cloudglides/AUB/images/1-staging.png

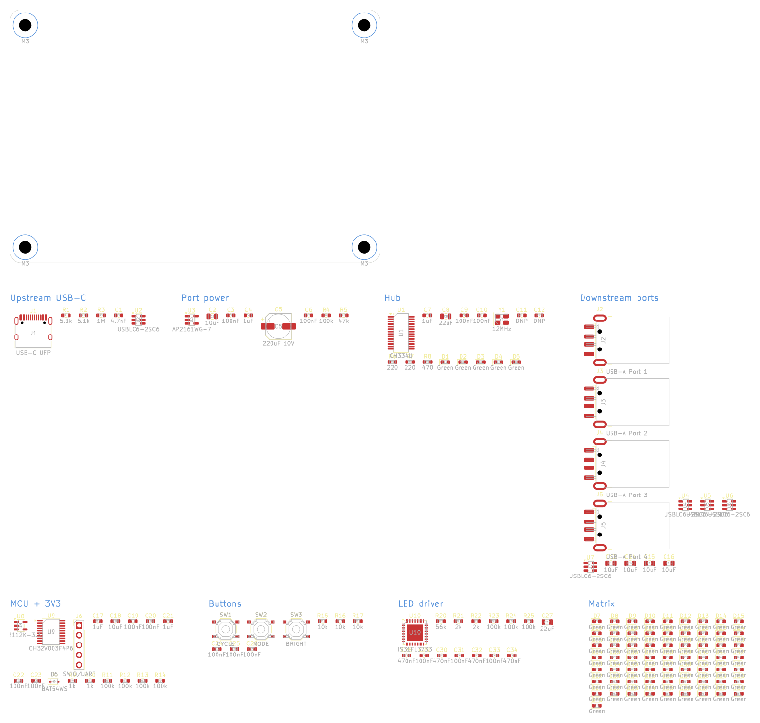
images/1-staging.png
