cloudglides/AUB/images/2-placement-3d.png

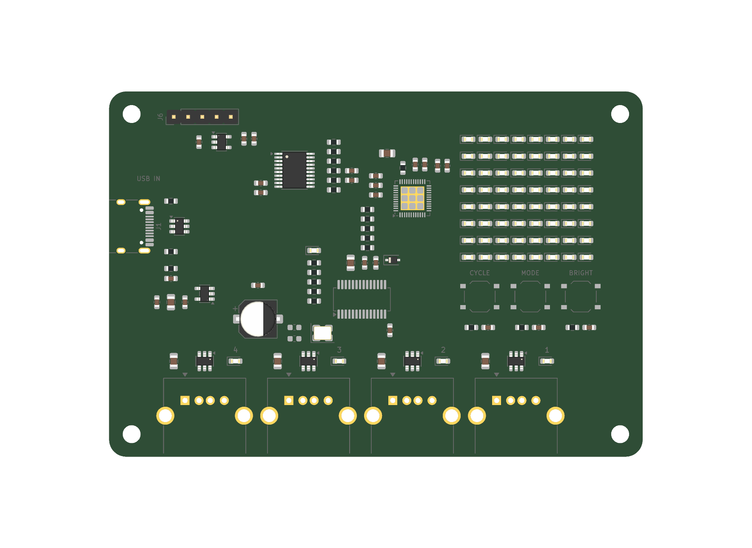
images/2-placement-3d.png
