cloudglides/AUB/images/2-placement-top.png

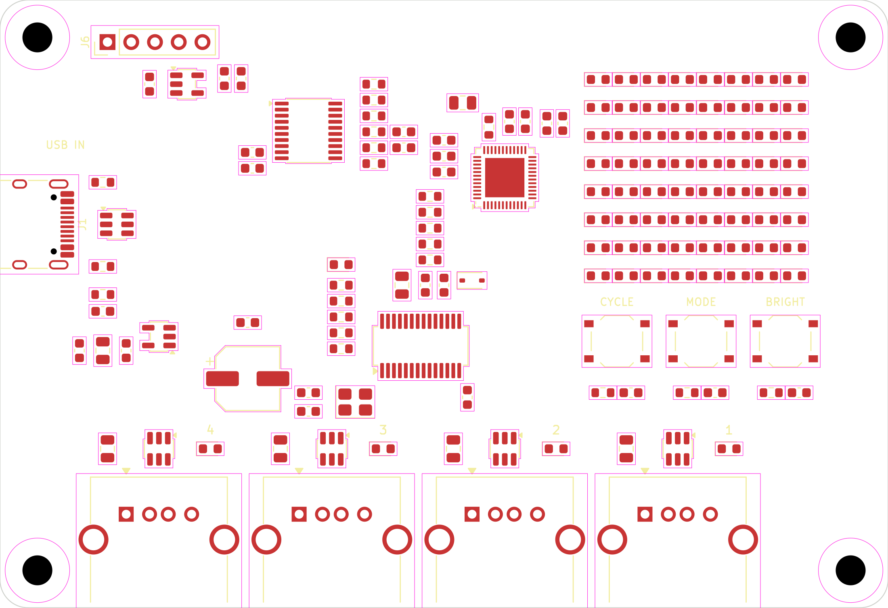
images/2-placement-top.png
