cloudglides/AUB/images/3-routing-wip-copper.png

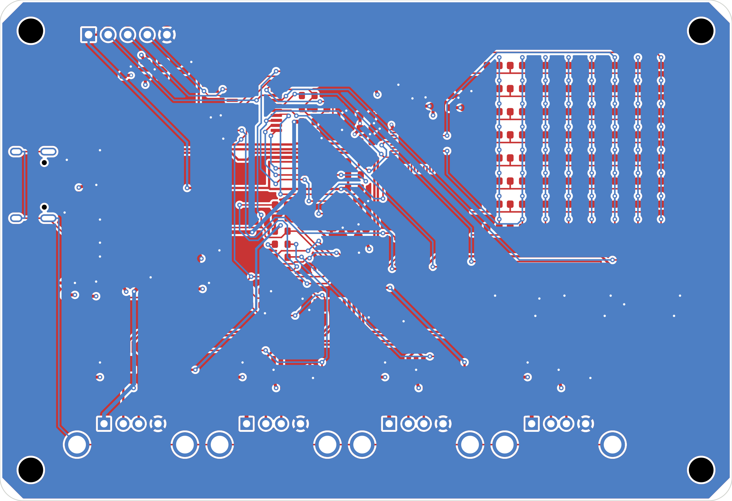
images/3-routing-wip-copper.png
