cloudglides/AUB/images/4-final-copper.png

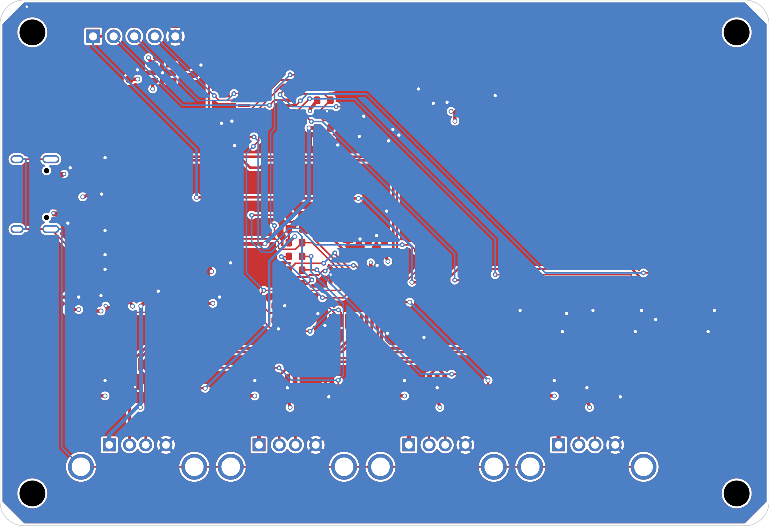
images/4-final-copper.png
