cloudglides/AUB/images/schematic.png

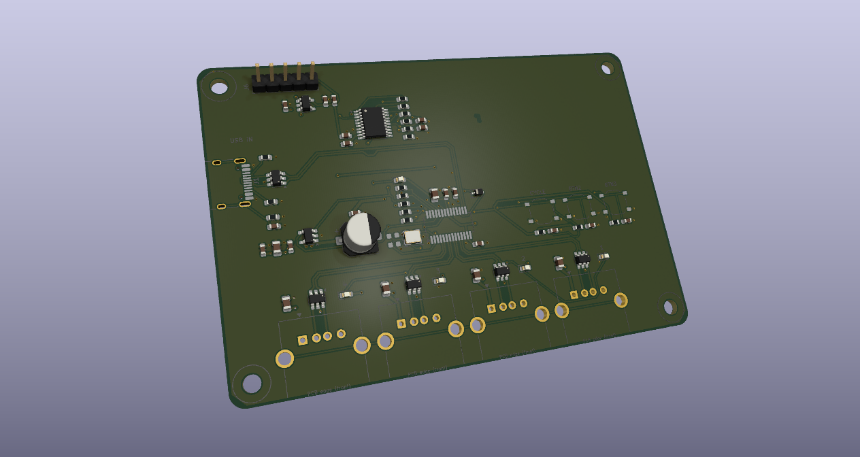
images/schematic.png
