cloudglides/AUB/BOM.csv

Comment | Designator | Footprint | LCSC Part # | Quantity
4.7nF | C1 | C_0603_1608Metric | C53987 | 1
10uF | C2,C13,C14,C15,C16 | C_0805_2012Metric | C15850 | 5
100nF | C3,C6,C9,C10,C19,C20,C22,C23,C24,C25,C26 | C_0603_1608Metric | C1591 | 11
1uF | C4,C7,C17,C21 | C_0603_1608Metric | C15849 | 4
220uF 10V | C5 | CP_Elec_6.3x7.7 | C5155344 | 1
22uF | C8 | C_0805_2012Metric | C602037 | 1
10uF | C18 | C_0603_1608Metric | C19702 | 1
Green | D1,D2,D3,D4,D5 | LED_0603_1608Metric | C7496818 | 5
BAT54WS | D6 | D_SOD-323 | C3040452 | 1
USB-C UFP | J1 | USB_C_Receptacle_HRO_TYPE-C-31-M-12 | C165948 | 1
USB-A Receptacle (902-131A1011D10100) | J2,J3,J4,J5 | USB_A_Receptacle_902-131A1011D10100 | C2345 | 4
SWIO/UART | J6 | PinHeader_1x05_P2.54mm_Vertical | C5156614 | 1
5.1k | R1,R2 | R_0603_1608Metric | C23186 | 2
1M | R3 | R_0603_1608Metric | C22935 | 1
100k | R4,R11,R12,R13,R14 | R_0603_1608Metric | C25803 | 5
47k | R5 | R_0603_1608Metric | C25819 | 1
220 | R6,R7 | R_0603_1608Metric | C22962 | 2
470 | R8 | R_0603_1608Metric | C23179 | 1
1k | R9,R10 | R_0603_1608Metric | C21190 | 2
10k | R15,R16,R17 | R_0603_1608Metric | C25804 | 3
Tactile Switch 5.1x5.1 (TS-1187A-B-A-B) | SW1,SW2,SW3 | SW_Push_1P1T_XKB_TS-1187A | C318884 | 3
CH334U | U1 | QSOP-28_3.9x9.9mm_P0.635mm | C5187524 | 1
USBLC6-2SC6 | U2,U4,U5,U6,U7 | SOT-23-6 | C7519 | 5
AP2161WG-7 | U3 | SOT-23-5 | C176957 | 1
AP2112K-3.3 | U8 | SOT-23-5 | C51118 | 1
CH32V003F4P6 | U9 | TSSOP-20_4.4x6.5mm_P0.65mm | C5187096 | 1
12MHz | Y1 | Crystal_SMD_3225-4Pin_3.2x2.5mm | C9002 | 1
