cloudglides/AUB/docs/AUB-schematic.pdf

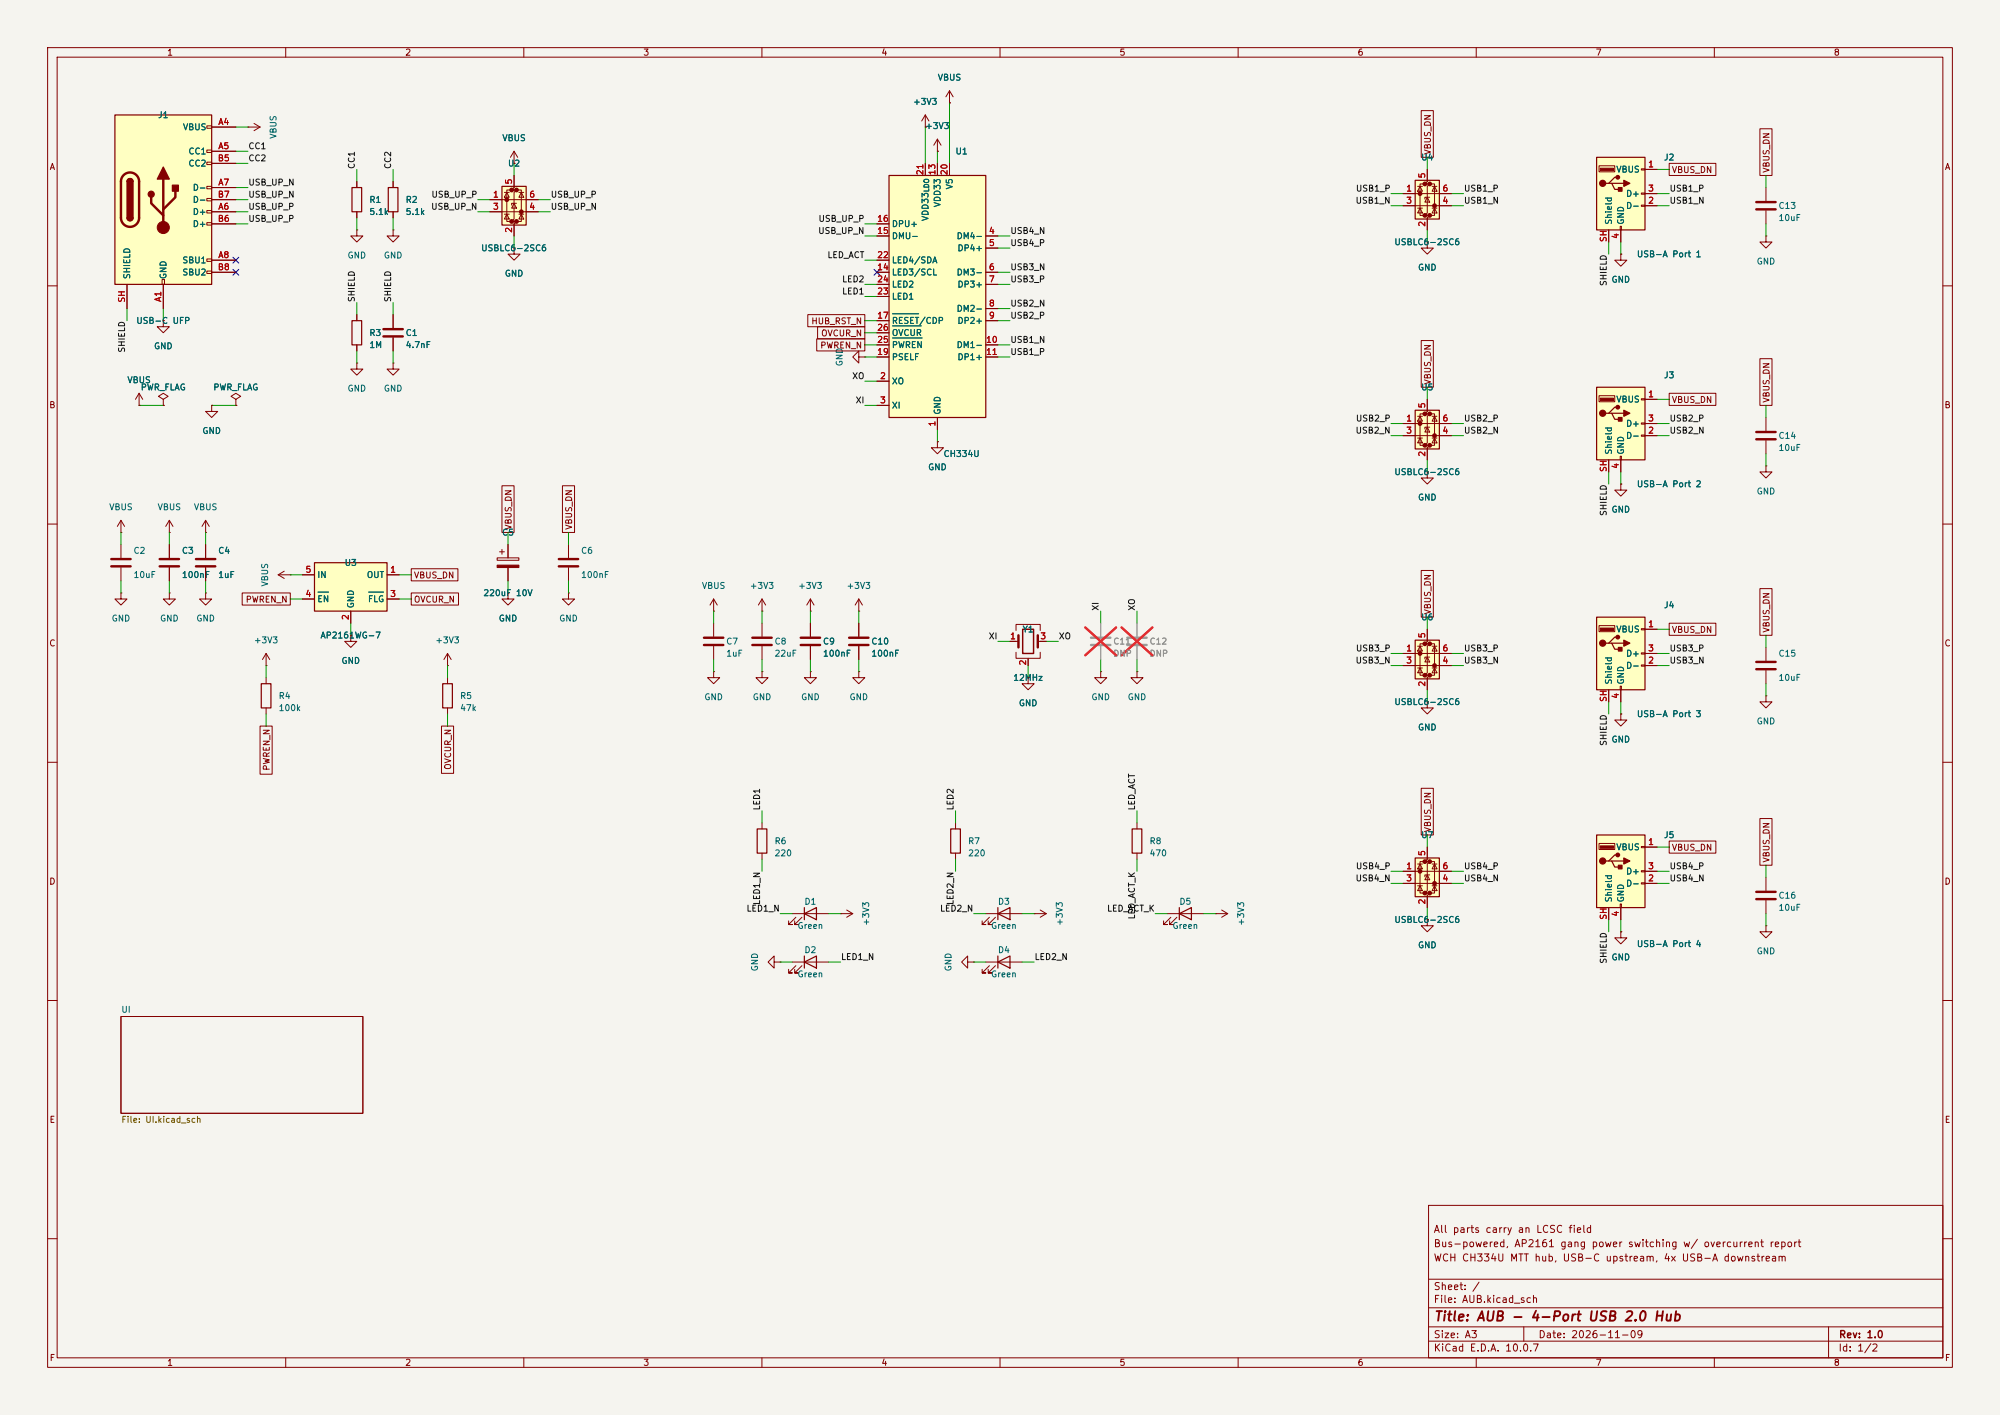
[picture p8: page 1]

J2 USB-A Port 1 GND GND

All parts carry an LCSC field
Bus-powered, AP2161 gang power switching w/ overcurrent report
WCH CH334U MTT hub, USB-C upstream, 4x USB-A downstream

Sheet: /
File: AUB.kicad_sch
Title: AUB - 4-Port USB 2.0 Hub

Size: A3 | Rev: 1.0 | F Date: 2026-11-09
KiCad E.D.A. 10.0.7 | Id: 1/2

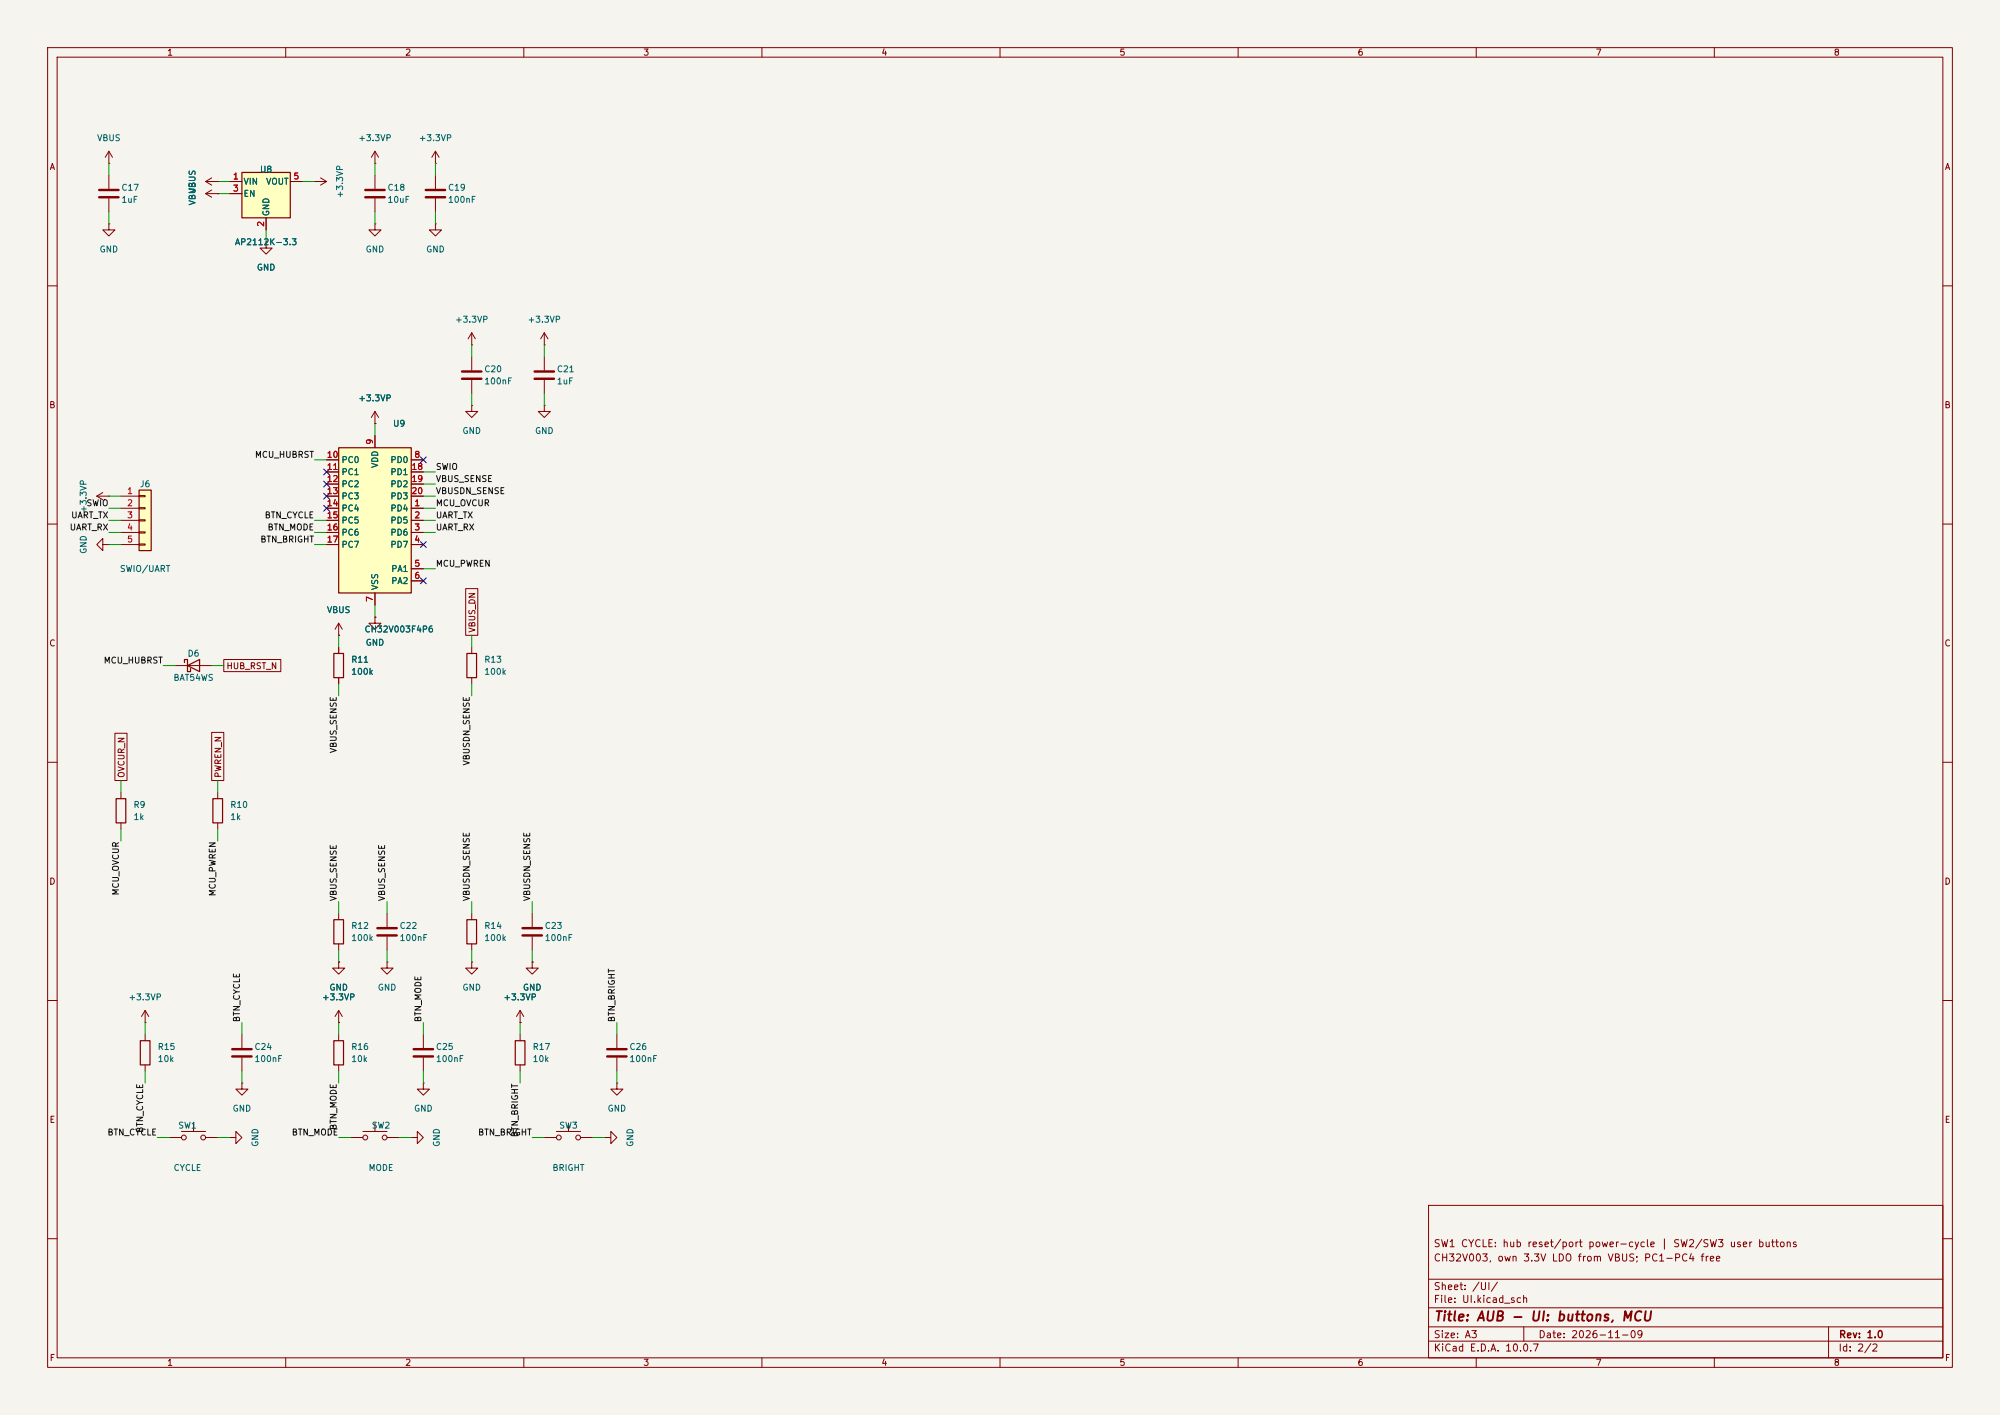
[picture p9: page 2]

SW1 CYCLE: hub reset/port power-cycle | SW2/SW3 user buttons GND

CH32V003, own 3.3V LDO from VBUS; PC1-PC4 free

Sheet: /UI/
File: UI.kicad_sch
Title: AUB - UI: buttons, MCU

Size: A3 | Rev: 1.0
KiCad E.D.A. 10.0.7 | Id: 2/2
