cloudglides/AUB/pcb/AUB.kicad_pcb

## KiCad design pcb/AUB.kicad_pcb (2026-11-09)

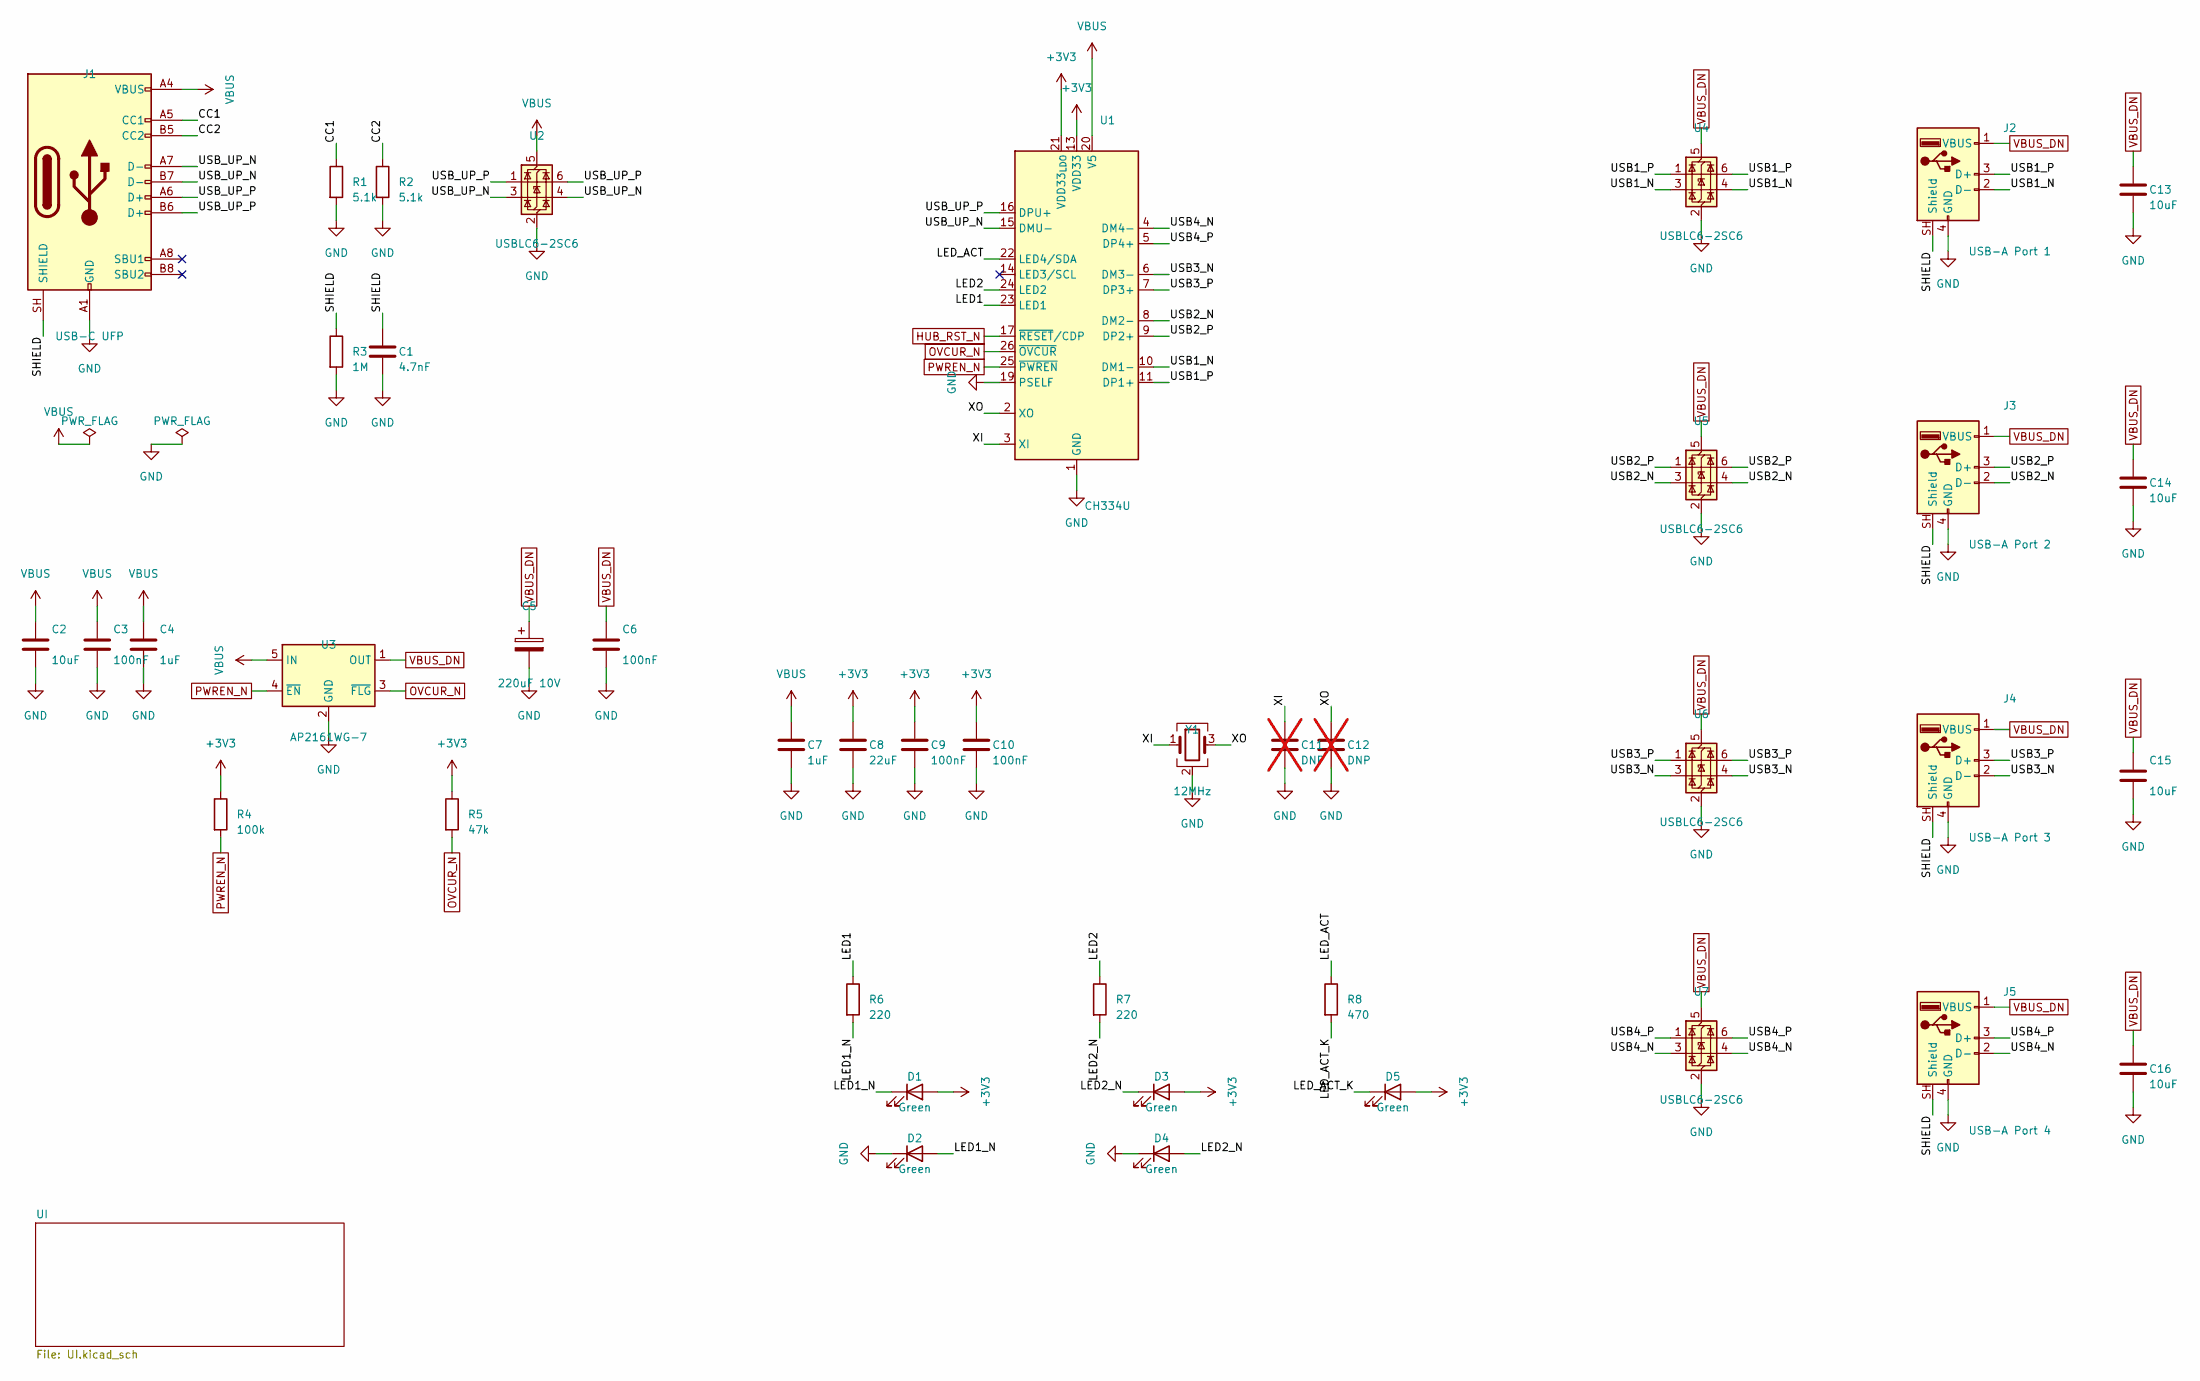
[picture p10: schematic AUB.kicad_sch, AUB - 4-Port USB 2.0 Hub]

Parts:
C1: 4.7nF; C_0603_1608Metric; LCSC C53987
C2, C13, C14, C15, C16: 10uF; C_0805_2012Metric; LCSC C15850
C3, C6, C9, C10: 100nF; C_0603_1608Metric; LCSC C1591
C4, C7: 1uF; C_0603_1608Metric; LCSC C15849
C5: 220uF 10V; CP_Elec_6.3x7.7; MPN FZ220UF10V90RV0151; LCSC C5155344
C8: 22uF; C_0805_2012Metric; LCSC C602037
C11, C12: DNP; C_0603_1608Metric; not fitted
D1, D2, D3, D4, D5: Green; LED_0603_1608Metric; LCSC C7496818
J1: USB-C UFP; USB_C_Receptacle_HRO_TYPE-C-31-M-12; MPN TYPE-C-31-M-12; LCSC C165948
J2: USB-A Port 1; USB_A_Receptacle_902-131A1011D10100; MPN 902-131A1011D10100; LCSC C2345
J3: USB-A Port 2; USB_A_Receptacle_902-131A1011D10100; MPN 902-131A1011D10100; LCSC C2345
J4: USB-A Port 3; USB_A_Receptacle_902-131A1011D10100; MPN 902-131A1011D10100; LCSC C2345
J5: USB-A Port 4; USB_A_Receptacle_902-131A1011D10100; MPN 902-131A1011D10100; LCSC C2345
R1, R2: 5.1k; R_0603_1608Metric; LCSC C23186
R3: 1M; R_0603_1608Metric; LCSC C22935
R4: 100k; R_0603_1608Metric; LCSC C25803
R5: 47k; R_0603_1608Metric; LCSC C25819
R6, R7: 220; R_0603_1608Metric; LCSC C22962
R8: 470; R_0603_1608Metric; LCSC C23179
U1: CH334U; QSOP-28_3.9x9.9mm_P0.635mm; MPN CH334U; LCSC C5187524
U2, U4, U5, U6, U7: USBLC6-2SC6; SOT-23-6; LCSC C7519
U3: AP2161WG-7; SOT-23-5; MPN AP2161WG-7; LCSC C176957
Y1: 12MHz; Crystal_SMD_3225-4Pin_3.2x2.5mm; MPN X322512MSB4SI; LCSC C9002

Connections:
+3V3: C8.1, C9.1, C10.1, D1.2 (A), D3.2 (A), D5.2 (A), R4.1, R5.1, U1.13 (VDD33), U1.21 (VDD33_{LDO})
/CC1: J1.A5 (CC1), R1.1
/CC2: J1.B5 (CC2), R2.1
/LED1: R6.1, U1.23 (LED1)
/LED1_N: D1.1 (K), D2.2 (A), R6.2
/LED2: R7.1, U1.24 (LED2)
/LED2_N: D3.1 (K), D4.2 (A), R7.2
/LED_ACT: R8.1, U1.22 (LED4/SDA)
/LED_ACT_K: D5.1 (K), R8.2
/SHIELD: C1.1, J1.SH (SHIELD), J2.SH (Shield), J3.SH (Shield), J4.SH (Shield), J5.SH (Shield), R3.1
/USB1_N: J2.2 (D-), U1.10 (DM1-), U4.3 (I/O2), U4.4 (I/O2)
/USB1_P: J2.3 (D+), U1.11 (DP1+), U4.1 (I/O1), U4.6 (I/O1)
/USB2_N: J3.2 (D-), U1.8 (DM2-), U5.3 (I/O2), U5.4 (I/O2)
/USB2_P: J3.3 (D+), U1.9 (DP2+), U5.1 (I/O1), U5.6 (I/O1)
/USB3_N: J4.2 (D-), U1.6 (DM3-), U6.3 (I/O2), U6.4 (I/O2)
/USB3_P: J4.3 (D+), U1.7 (DP3+), U6.1 (I/O1), U6.6 (I/O1)
/USB4_N: J5.2 (D-), U1.4 (DM4-), U7.3 (I/O2), U7.4 (I/O2)
/USB4_P: J5.3 (D+), U1.5 (DP4+), U7.1 (I/O1), U7.6 (I/O1)
/USB_UP_N: J1.A7 (D-), J1.B7 (D-), U1.15 (DMU-), U2.3 (I/O2), U2.4 (I/O2)
/USB_UP_P: J1.A6 (D+), J1.B6 (D+), U1.16 (DPU+), U2.1 (I/O1), U2.6 (I/O1)
/XI: C11.1, U1.3 (XI), Y1.1
/XO: C12.1, U1.2 (XO), Y1.3
GND: C1.2, C2.2, C3.2, C4.2, C5.2, C6.2, C7.2, C8.2, C9.2, C10.2, C11.2, C12.2, C13.2, C14.2, C15.2, C16.2, D2.1 (K), D4.1 (K), J1.A1 (GND), J1.A12 (GND), J1.B1 (GND), J1.B12 (GND), J2.4 (GND), J3.4 (GND), J4.4 (GND), J5.4 (GND), R1.2, R2.2, R3.2, U1.1 (GND), U1.12 (GND), U1.19 (PSELF), U1.28 (GND), U2.2 (GND), U3.2 (GND), U4.2 (GND), U5.2 (GND), U6.2 (GND), U7.2 (GND), Y1.2 (G), Y1.4 (G); also elsewhere on the board
HUB_RST_N: U1.17 (~RESET/CDP); also elsewhere on the board
OVCUR_N: R5.2, U1.26 (~OVCUR), U3.3 (~FLG); also elsewhere on the board
PWREN_N: R4.2, U1.25 (~PWREN), U3.4 (~EN); also elsewhere on the board
VBUS: C2.1, C3.1, C4.1, C7.1, J1.A4 (VBUS), J1.A9 (VBUS), J1.B4 (VBUS), J1.B9 (VBUS), U1.20 (V5), U2.5 (VBUS), U3.5 (IN); also elsewhere on the board
VBUS_DN: C5.1, C6.1, C13.1, C14.1, C15.1, C16.1, J2.1 (VBUS), J3.1 (VBUS), J4.1 (VBUS), J5.1 (VBUS), U3.1 (OUT), U4.5 (VBUS), U5.5 (VBUS), U6.5 (VBUS), U7.5 (VBUS); also elsewhere on the board

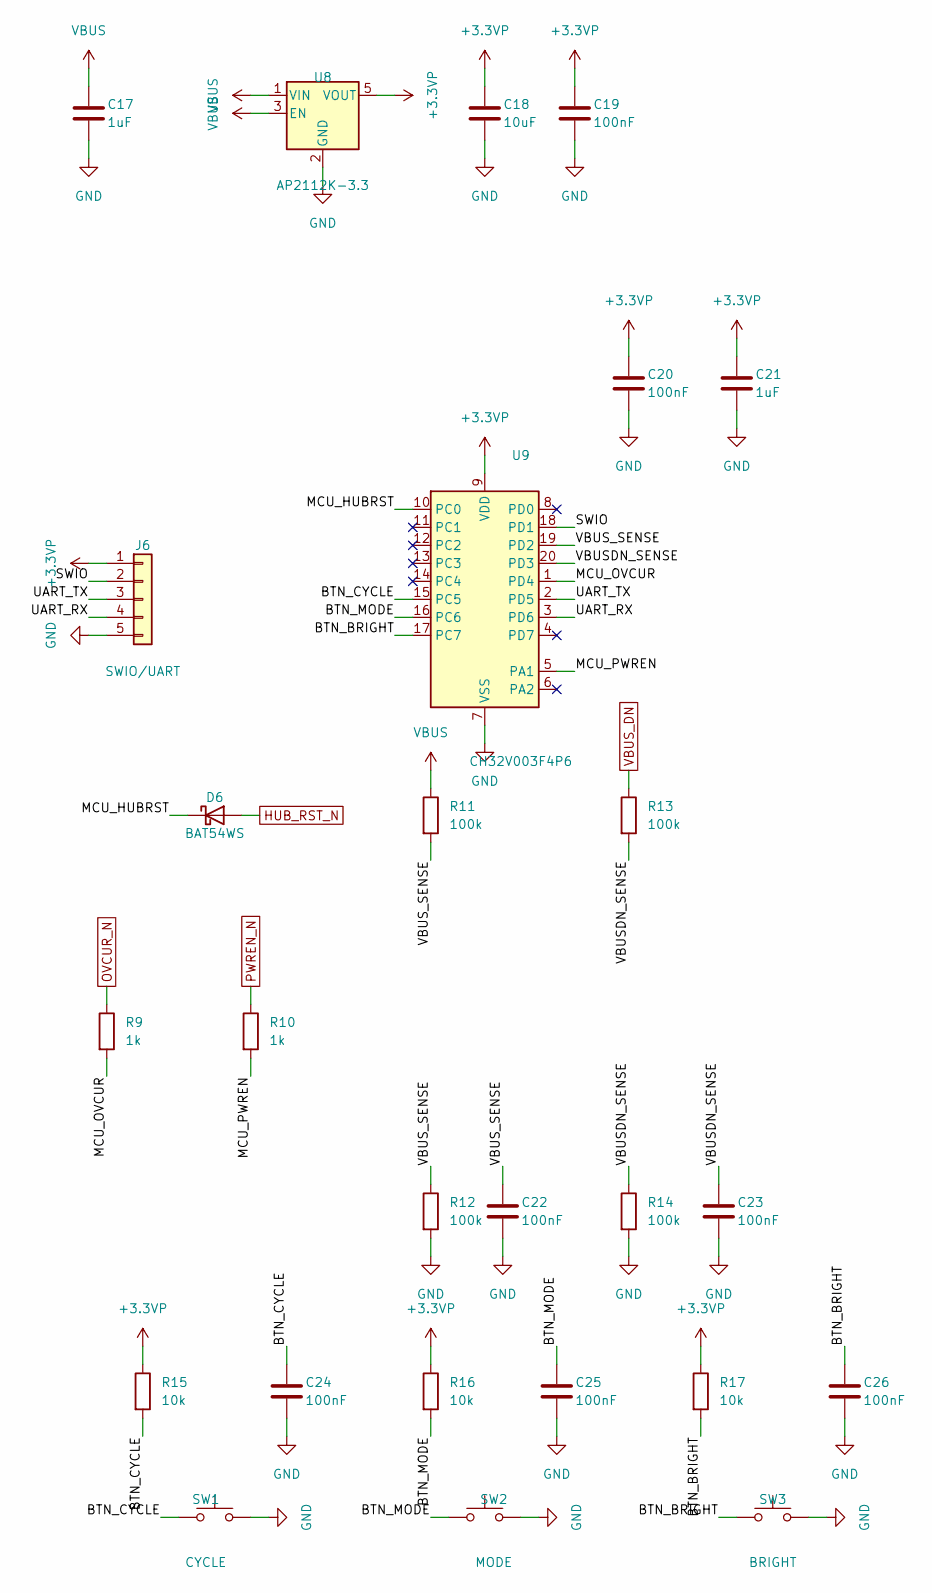
[picture p11: schematic UI.kicad_sch, AUB - UI: buttons, MCU]

Parts:
C17, C21: 1uF; C_0603_1608Metric; LCSC C15849
C18: 10uF; C_0603_1608Metric; LCSC C19702
C19, C20, C22, C23, C24, C25, C26: 100nF; C_0603_1608Metric; LCSC C1591
D6: BAT54WS; D_SOD-323; LCSC C3040452
J6: SWIO/UART; PinHeader_1x05_P2.54mm_Vertical; LCSC C5156614
R9, R10: 1k; R_0603_1608Metric; LCSC C21190
R11, R12, R13, R14: 100k; R_0603_1608Metric; LCSC C25803
R15, R16, R17: 10k; R_0603_1608Metric; LCSC C25804
SW1: CYCLE; SW_Push_1P1T_XKB_TS-1187A; MPN TS-1187A-B-A-B; LCSC C318884
SW2: MODE; SW_Push_1P1T_XKB_TS-1187A; MPN TS-1187A-B-A-B; LCSC C318884
SW3: BRIGHT; SW_Push_1P1T_XKB_TS-1187A; MPN TS-1187A-B-A-B; LCSC C318884
U8: AP2112K-3.3; SOT-23-5; MPN AP2112K-3.3TRG1; LCSC C51118
U9: CH32V003F4P6; TSSOP-20_4.4x6.5mm_P0.65mm; MPN CH32V003F4P6; LCSC C5187096

Connections:
+3.3VP: C18.1, C19.1, C20.1, C21.1, J6.1, R15.1, R16.1, R17.1, U8.5 (VOUT), U9.9 (VDD)
/UI/BTN_BRIGHT: C26.1, R17.2, SW3.1, U9.17 (PC7)
/UI/BTN_CYCLE: C24.1, R15.2, SW1.1, U9.15 (PC5)
/UI/BTN_MODE: C25.1, R16.2, SW2.1, U9.16 (PC6)
/UI/MCU_HUBRST: D6.1 (K), U9.10 (PC0)
/UI/MCU_OVCUR: R9.2, U9.1 (PD4)
/UI/MCU_PWREN: R10.2, U9.5 (PA1)
/UI/SWIO: J6.2, U9.18 (PD1)
/UI/UART_RX: J6.4, U9.3 (PD6)
/UI/UART_TX: J6.3, U9.2 (PD5)
/UI/VBUSDN_SENSE: C23.1, R13.2, R14.1, U9.20 (PD3)
/UI/VBUS_SENSE: C22.1, R11.2, R12.1, U9.19 (PD2)
GND: C17.2, C18.2, C19.2, C20.2, C21.2, C22.2, C23.2, C24.2, C25.2, C26.2, J6.5, R12.2, R14.2, SW1.2, SW2.2, SW3.2, U8.2 (GND), U9.7 (VSS); also elsewhere on the board
HUB_RST_N: D6.2 (A); also elsewhere on the board
OVCUR_N: R9.1; also elsewhere on the board
PWREN_N: R10.1; also elsewhere on the board
VBUS: C17.1, R11.1, U8.1 (VIN), U8.3 (EN); also elsewhere on the board
VBUS_DN: R13.1; also elsewhere on the board

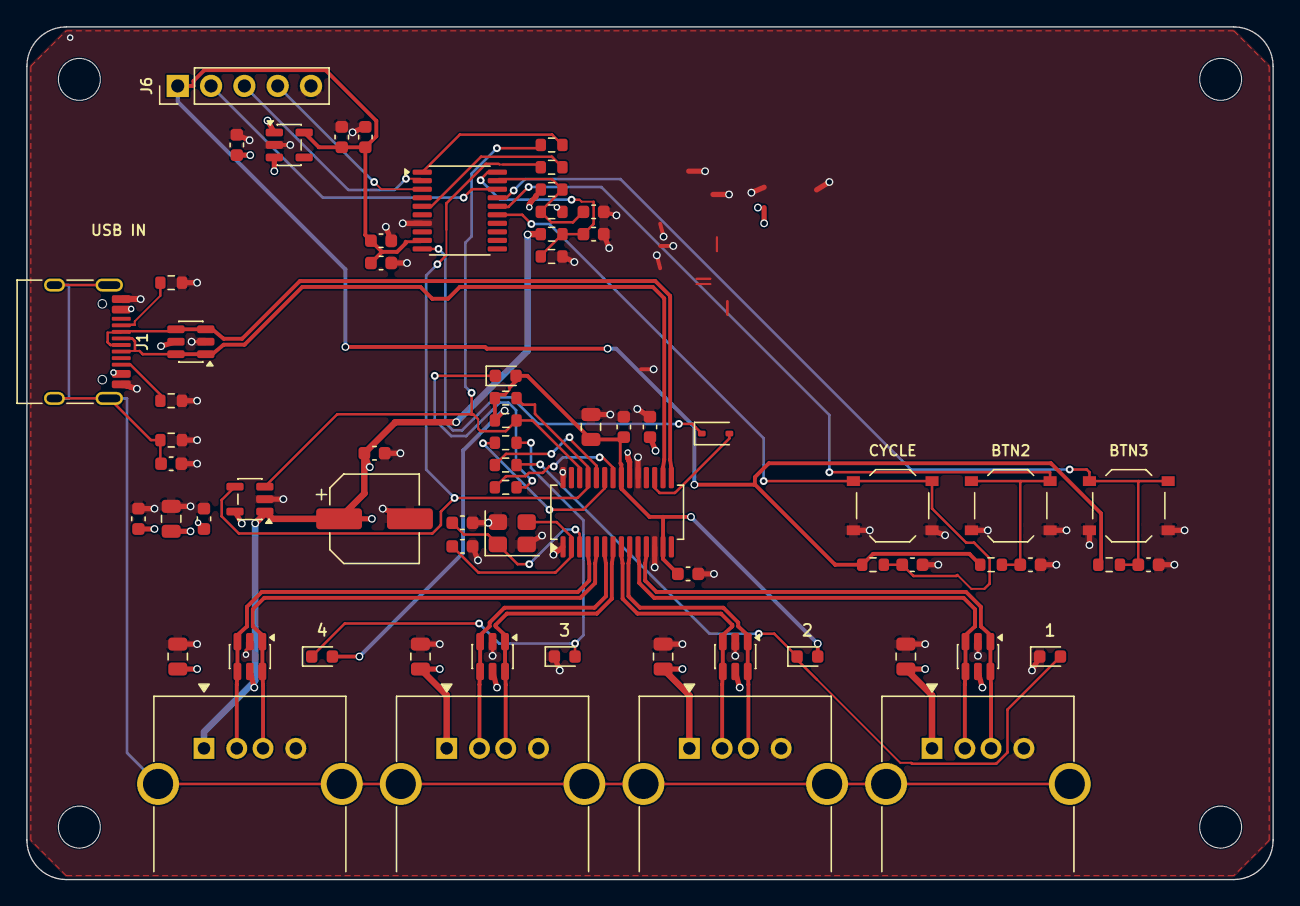
[picture p12: board AUB.kicad_pcb from above]

Board: 4 copper layers, 95.0 x 65.0 mm, 72 parts (0 on the bottom side), 40 nets.

Other parts of the board:
H1, H2, H3, H4: M3; MountingHole_3.2mm_M3
