cloudglides/AUB/(commit log)

2026-11-09 hey there!!
    [AUB.kicad_pcb, AUB.kicad_sch, BOM.csv, UI.kicad_sch, bom.csv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]
2026-11-09 Update project log with time and activity details
    Updated total time spent on the project and added details for Day 3 and Day 4 activities, including PCB routing and case design.
